DawidKM2026/KM-2026/hello_world/DP_Platform/docs/3d_modeling_files/02_adapter_fl57sth76_gt2/img/fl57sth76_gt2_adapter.png

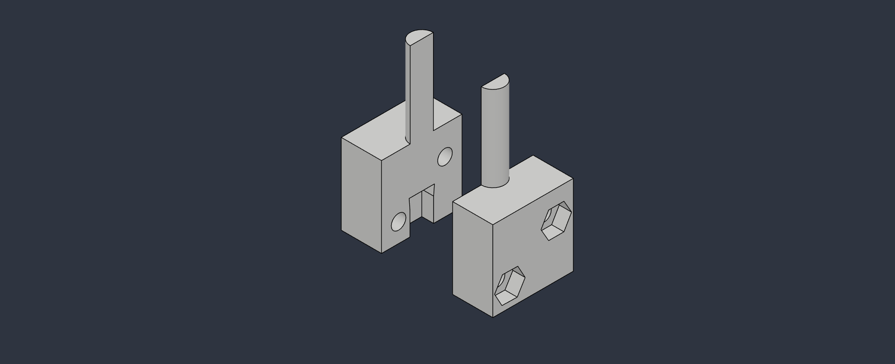
hello_world/DP_Platform/docs/3d_modeling_files/02_adapter_fl57sth76_gt2/img/fl57sth76_gt2_adapter.png
