DawidKM2026/KM-2026/hello_world/DP_Platform/docs/3d_modeling_files/01_spm/cad/rsb-01_axis-main.step

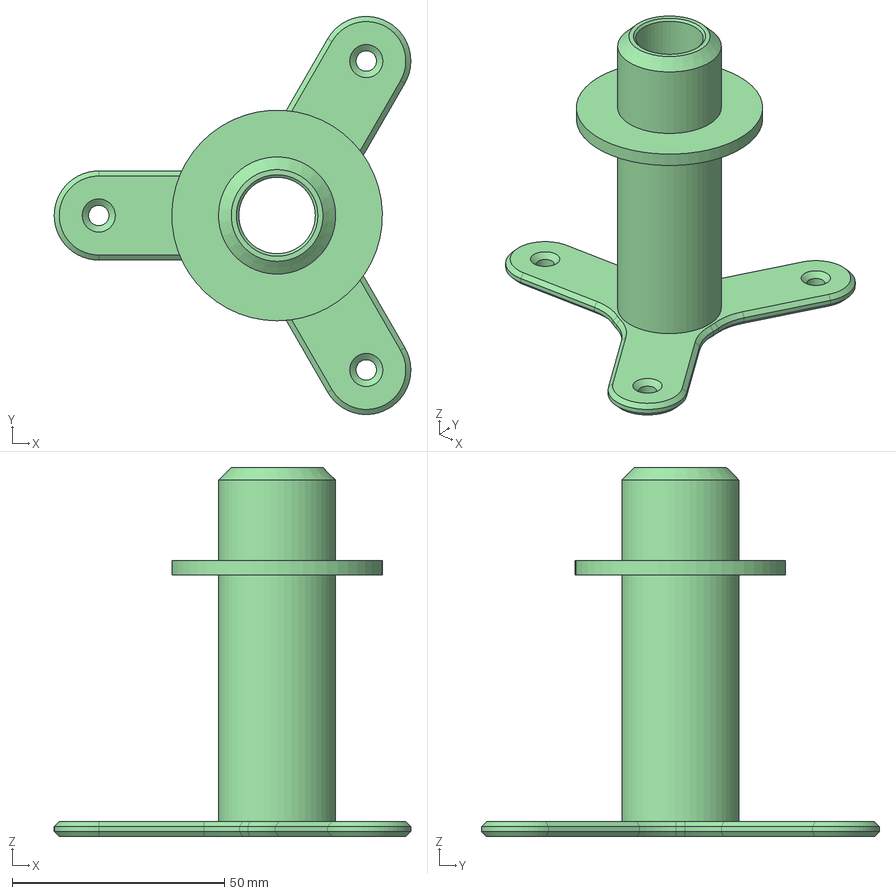
[picture p30: CAD file, 2026-08-04]
hello_world/DP_Platform/docs/3d_modeling_files/01_spm/cad/rsb-01_axis-main.step
84.0 x 93.7 x 87.0 mm
