DawidKM2026/KM-2026/hello_world/DP_Platform/docs/3d_modeling_files/02_adapter_fl57sth76_gt2/cad/fl57sth76_gt2_adapter.step

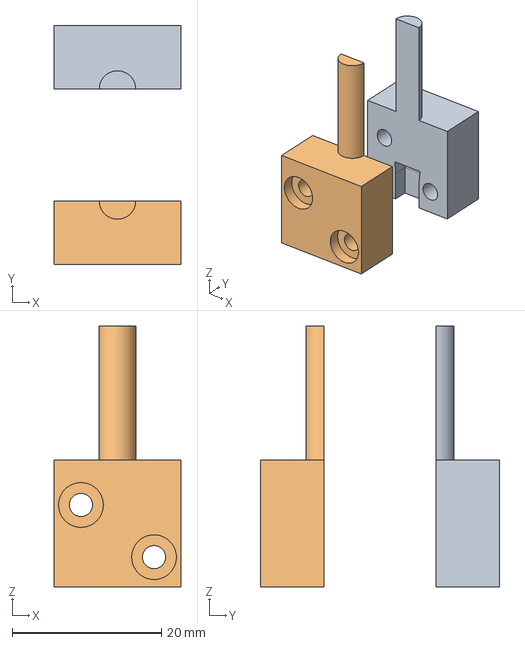
[picture p32: CAD file, 2026-08-04]
hello_world/DP_Platform/docs/3d_modeling_files/02_adapter_fl57sth76_gt2/cad/fl57sth76_gt2_adapter.step
17.0 x 32.0 x 35.0 mm
