DawidKM2026/KM-2026/hello_world/DP_Platform/docs/3d_modeling_files/03_eth_mount/cad/eth_mount.step

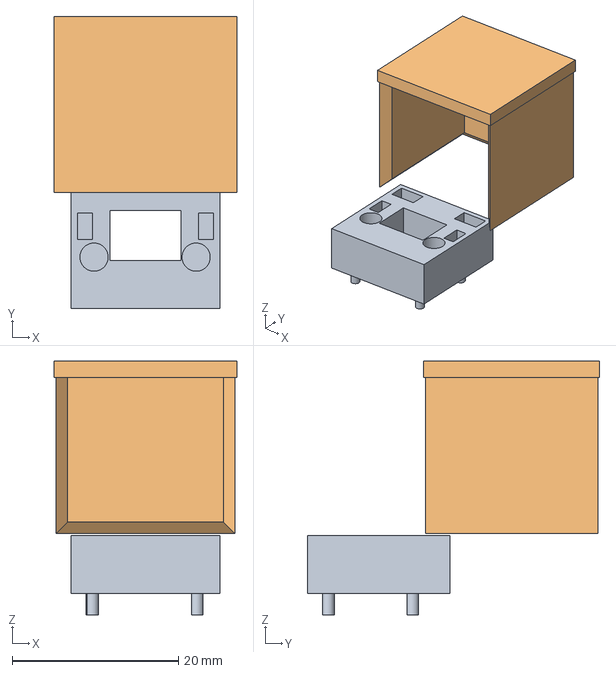
[picture p33: CAD file, 2026-08-04]
hello_world/DP_Platform/docs/3d_modeling_files/03_eth_mount/cad/eth_mount.step
22.0 x 35.2 x 30.6 mm
