DawidKM2026/KM-2026/hello_world/DP_Platform/docs/3d_modeling_files/04_eth_usb_mount/cad/eth_usb_mount.step

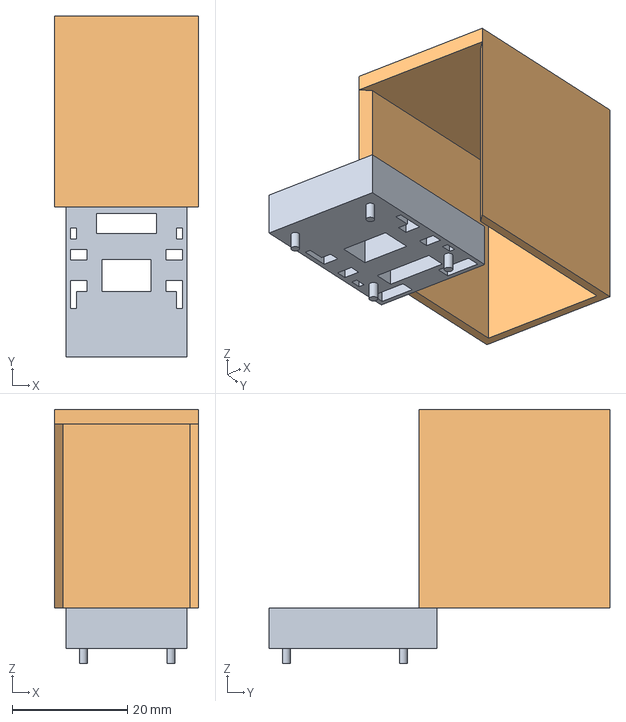
[picture p34: CAD file, 2026-08-04]
hello_world/DP_Platform/docs/3d_modeling_files/04_eth_usb_mount/cad/eth_usb_mount.step
25.0 x 59.2 x 44.1 mm
