DawidKM2026/KM-2026/hello_world/DP_Platform/docs/3d_modeling_files/05_mounting_base_xl4016/cad/mounting_base_xl4016.step

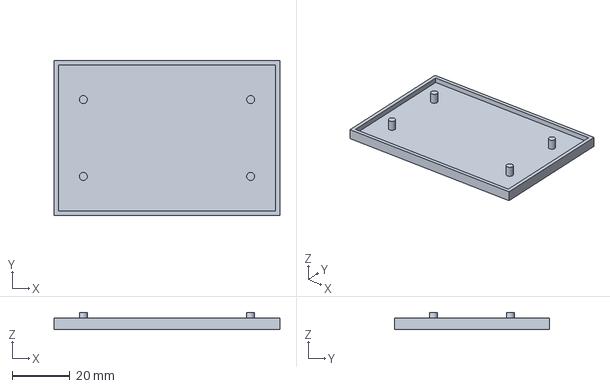
[picture p35: CAD file, 2026-08-04]
hello_world/DP_Platform/docs/3d_modeling_files/05_mounting_base_xl4016/cad/mounting_base_xl4016.step
78.5 x 53.7 x 6.00 mm
