DawidKM2026/KM-2026/hello_world/DP_Platform/docs/3d_modeling_files/06_expansion_platform_gantry/cad/expansion_platform_gantry.step

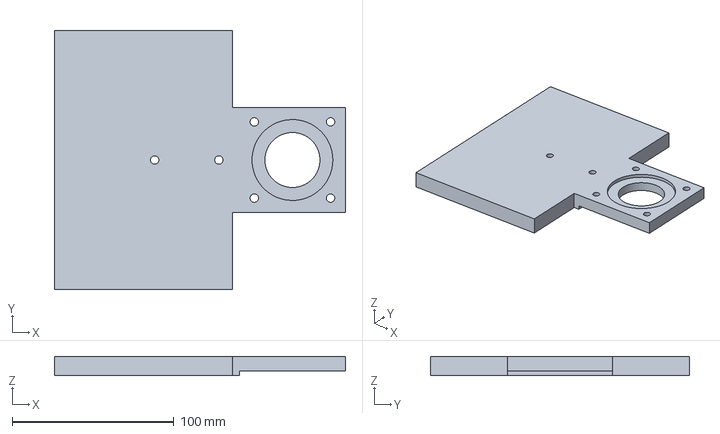
[picture p36: CAD file, 2026-08-04]
hello_world/DP_Platform/docs/3d_modeling_files/06_expansion_platform_gantry/cad/expansion_platform_gantry.step
179.9 x 160.0 x 12.0 mm
