DawidKM2026/KM-2026/hello_world/DP_Platform/docs/3d_modeling_files/07_riser_feet_2020/cad/riser_leg.step

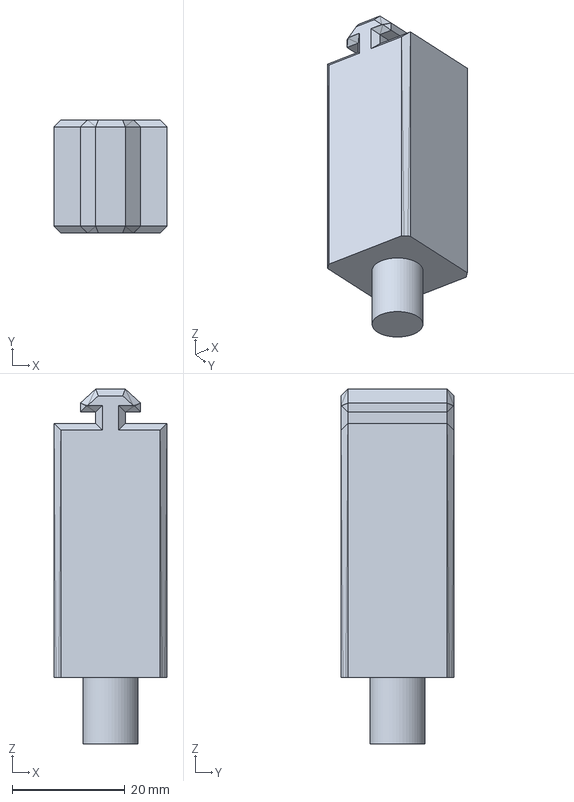
[picture p37: CAD file, 2026-08-04]
hello_world/DP_Platform/docs/3d_modeling_files/07_riser_feet_2020/cad/riser_leg.step
20.0 x 20.0 x 62.9 mm
