DawidKM2026/KM-2026/hello_world/DP_Platform/docs/3d_modeling_files/08_mount_gear_jk42hs34/cad/gear.step

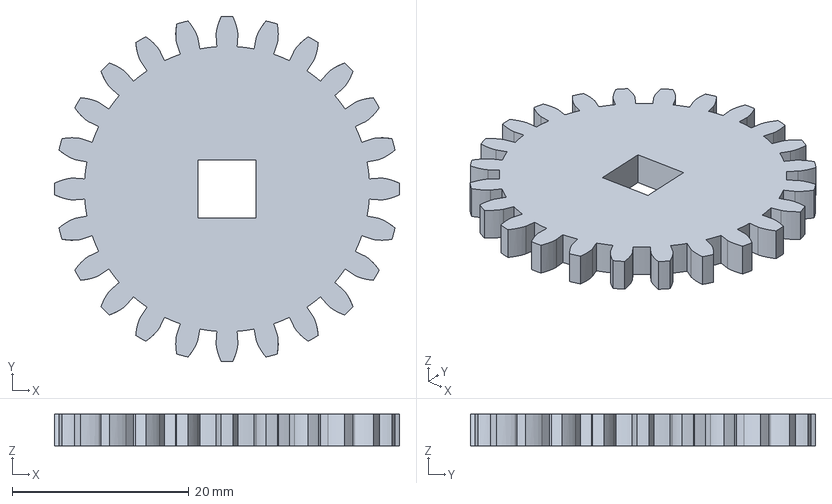
[picture p38: CAD file, 2026-08-04]
hello_world/DP_Platform/docs/3d_modeling_files/08_mount_gear_jk42hs34/cad/gear.step
39.0 x 39.0 x 3.60 mm
