DawidKM2026/KM-2026/hello_world/DP_Platform/docs/3d_modeling_files/09_fl57sth76_mount_vslot_frame/cad/fl57sth76_vslot_mount.step

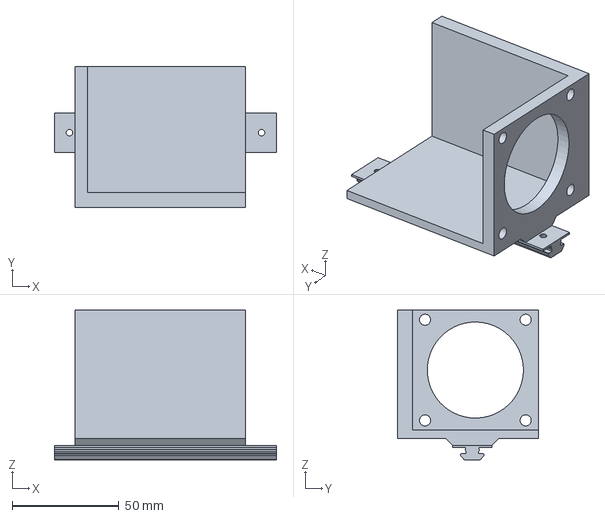
[picture p39: CAD file, 2026-08-04]
hello_world/DP_Platform/docs/3d_modeling_files/09_fl57sth76_mount_vslot_frame/cad/fl57sth76_vslot_mount.step
104.0 x 66.0 x 70.2 mm
