DawidKM2026/KM-2026/hello_world/DP_Platform/docs/3d_modeling_files/10_sar_brage_hull/cad/sar_brage.step

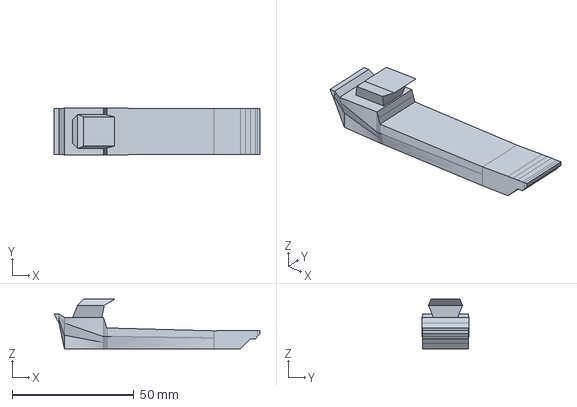
[picture p40: CAD file, 2026-08-04]
hello_world/DP_Platform/docs/3d_modeling_files/10_sar_brage_hull/cad/sar_brage.step
84.7 x 19.2 x 20.4 mm
