DawidKM2026/KM-2026/hello_world/DP_Platform/docs/3d_modeling_files/11_vslot_corner_bracket/cad/45Bracket_.step

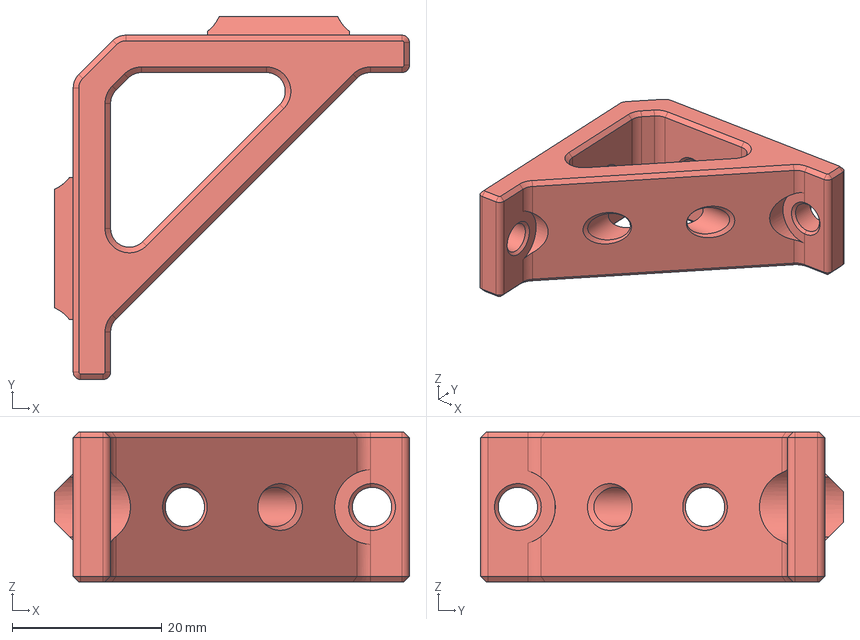
[picture p41: CAD file, 2026-08-06]
hello_world/DP_Platform/docs/3d_modeling_files/11_vslot_corner_bracket/cad/45Bracket_.step
47.4 x 48.5 x 20.0 mm
