DawidKM2026/KM-2026/hello_world/DP_Platform/docs/3d_modeling_files/01_spm/cad/rsb-01_base-axis-01_gear_version.step

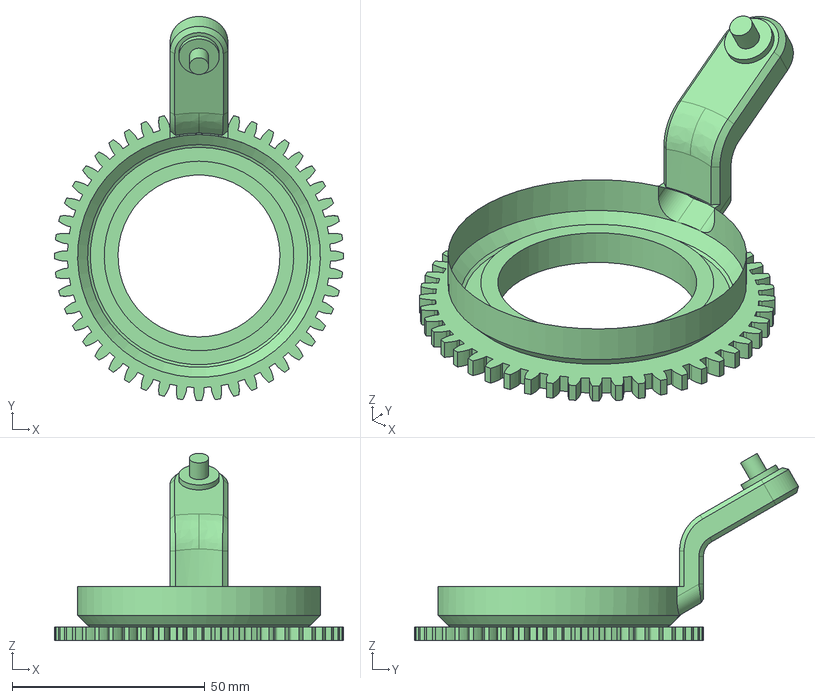
[picture p42: CAD file, 2026-08-04]
hello_world/DP_Platform/docs/3d_modeling_files/01_spm/cad/rsb-01_base-axis-01_gear_version.step
75.0 x 99.6 x 48.6 mm
