DawidKM2026/KM-2026/hello_world/DP_Platform/docs/3d_modeling_files/07_riser_feet_2020/cad/expanding_foot.step

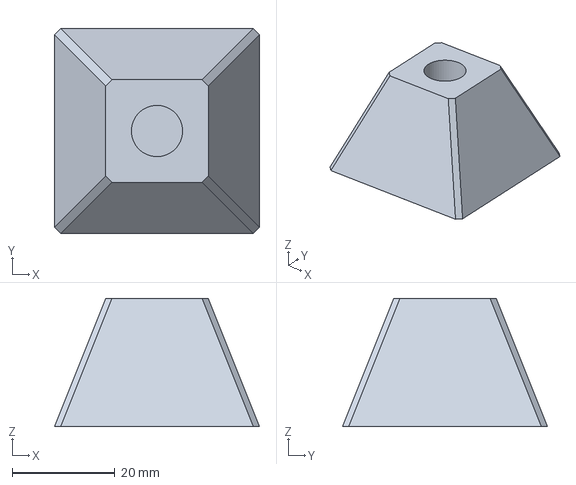
[picture p43: CAD file, 2026-08-04]
hello_world/DP_Platform/docs/3d_modeling_files/07_riser_feet_2020/cad/expanding_foot.step
40.0 x 40.0 x 25.0 mm
