DawidKM2026/KM-2026/hello_world/DP_Platform/docs/3d_modeling_files/01_spm/cad/rsb-01_base-axis-03_gear_version.step

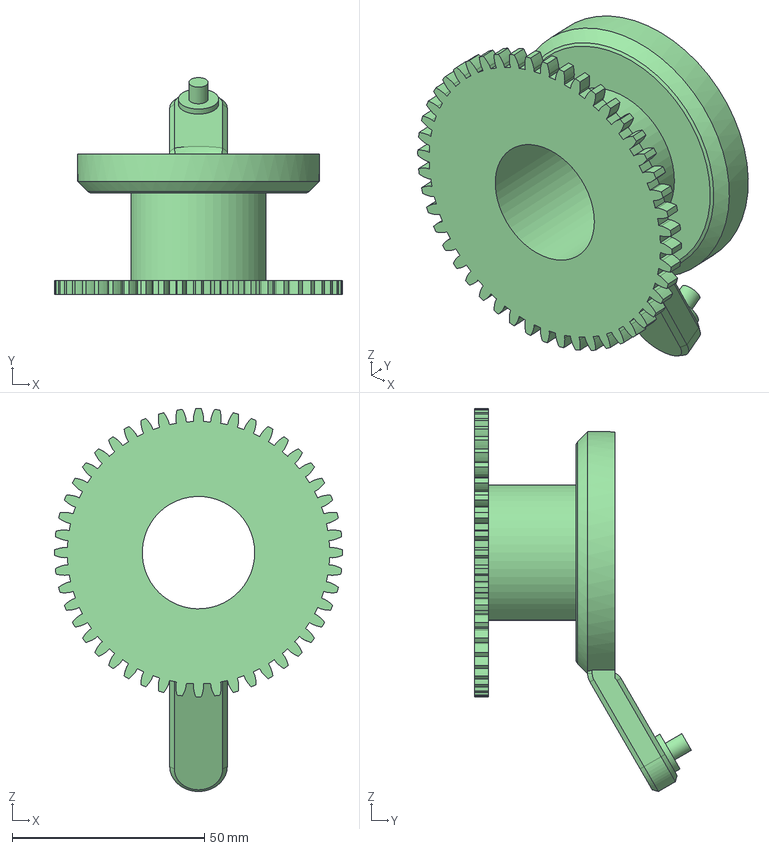
[picture p44: CAD file, 2026-08-04]
hello_world/DP_Platform/docs/3d_modeling_files/01_spm/cad/rsb-01_base-axis-03_gear_version.step
75.0 x 56.4 x 99.6 mm
