DawidKM2026/KM-2026/hello_world/DP_Platform/docs/3d_modeling_files/01_spm/cad/rsb-01_arm-axis-all.step

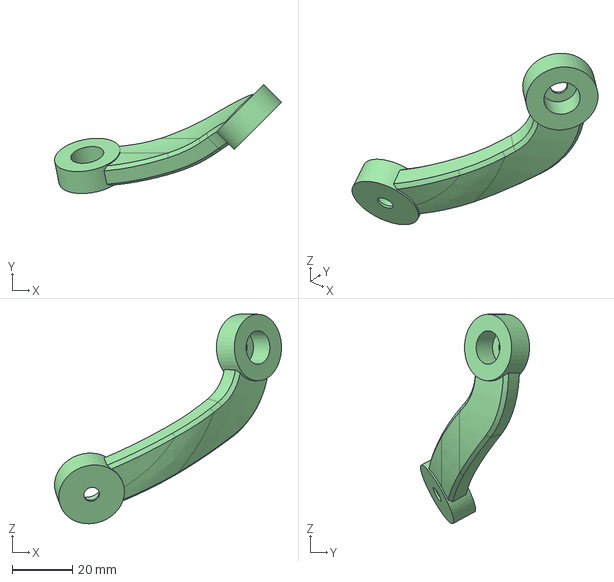
[picture p45: CAD file, 2026-08-04]
hello_world/DP_Platform/docs/3d_modeling_files/01_spm/cad/rsb-01_arm-axis-all.step
75.2 x 36.1 x 69.4 mm
