DawidKM2026/KM-2026/hello_world/DP_Platform/docs/3d_modeling_files/08_mount_gear_jk42hs34/cad/bolted_clamp.step

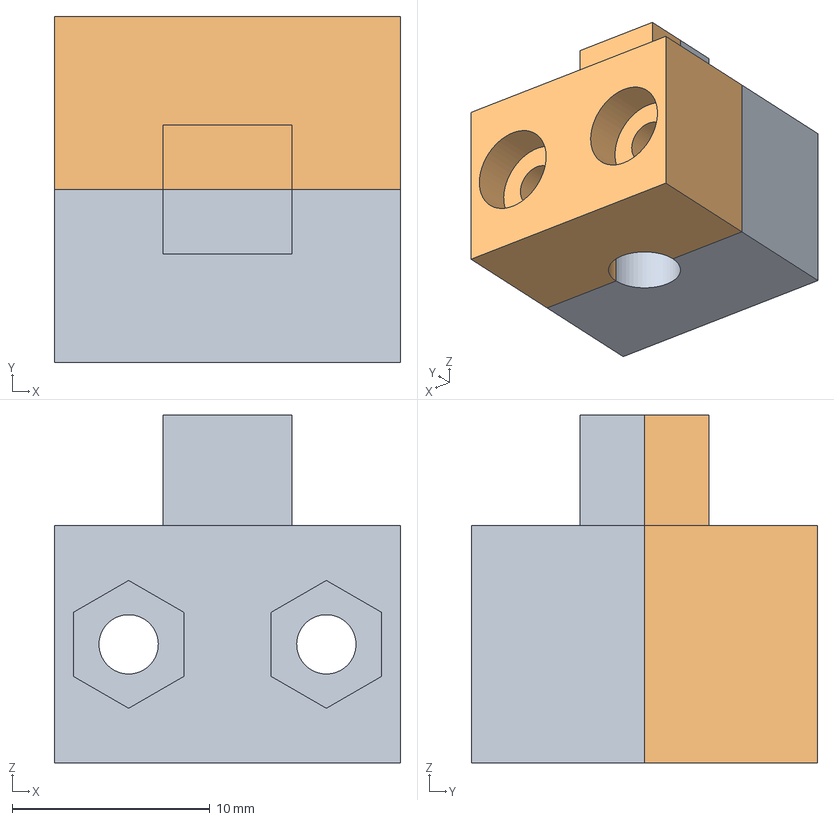
[picture p47: CAD file, 2026-08-04]
hello_world/DP_Platform/docs/3d_modeling_files/08_mount_gear_jk42hs34/cad/bolted_clamp.step
17.5 x 17.5 x 17.6 mm
