DawidKM2026/KM-2026/(list of files, cad)

Other CAD files:
hello_world/DP_Platform/docs/3d_modeling_files/01_spm/cad/rsb-01_arm-axis-all.3mf
hello_world/DP_Platform/docs/3d_modeling_files/01_spm/cad/rsb-01_arm-axis-all.f3d
hello_world/DP_Platform/docs/3d_modeling_files/01_spm/cad/rsb-01_axis-main.3mf
hello_world/DP_Platform/docs/3d_modeling_files/01_spm/cad/rsb-01_axis-main.f3d
hello_world/DP_Platform/docs/3d_modeling_files/01_spm/cad/rsb-01_base-axis-01_gear_version.3mf
hello_world/DP_Platform/docs/3d_modeling_files/01_spm/cad/rsb-01_base-axis-01_gear_version.f3d
hello_world/DP_Platform/docs/3d_modeling_files/01_spm/cad/rsb-01_base-axis-02_gear_version.3mf
hello_world/DP_Platform/docs/3d_modeling_files/01_spm/cad/rsb-01_base-axis-02_gear_version.f3d
hello_world/DP_Platform/docs/3d_modeling_files/01_spm/cad/rsb-01_base-axis-03_gear_version.3mf
hello_world/DP_Platform/docs/3d_modeling_files/01_spm/cad/rsb-01_base-axis-03_gear_version.f3d
hello_world/DP_Platform/docs/3d_modeling_files/01_spm/cad/rsb-01_top.3mf
hello_world/DP_Platform/docs/3d_modeling_files/01_spm/cad/rsb-01_top.f3d
hello_world/DP_Platform/docs/3d_modeling_files/02_adapter_fl57sth76_gt2/cad/fl57sth76_gt2_adapter.3mf
hello_world/DP_Platform/docs/3d_modeling_files/02_adapter_fl57sth76_gt2/cad/fl57sth76_gt2_adapter.f3d
hello_world/DP_Platform/docs/3d_modeling_files/03_eth_mount/cad/eth_mount.3mf
hello_world/DP_Platform/docs/3d_modeling_files/03_eth_mount/cad/eth_mount.f3d
hello_world/DP_Platform/docs/3d_modeling_files/04_eth_usb_mount/cad/eth_usb_mount.3mf
hello_world/DP_Platform/docs/3d_modeling_files/04_eth_usb_mount/cad/eth_usb_mount.f3d
hello_world/DP_Platform/docs/3d_modeling_files/05_mounting_base_xl4016/cad/mounting_base_xl4016.3mf
hello_world/DP_Platform/docs/3d_modeling_files/05_mounting_base_xl4016/cad/mounting_base_xl4016.f3d
hello_world/DP_Platform/docs/3d_modeling_files/06_expansion_platform_gantry/cad/expansion_platform_gantry.3mf
hello_world/DP_Platform/docs/3d_modeling_files/06_expansion_platform_gantry/cad/expansion_platform_gantry.f3d
hello_world/DP_Platform/docs/3d_modeling_files/07_riser_feet_2020/cad/expanding_foot.3mf
hello_world/DP_Platform/docs/3d_modeling_files/07_riser_feet_2020/cad/expanding_foot.f3d
hello_world/DP_Platform/docs/3d_modeling_files/07_riser_feet_2020/cad/riser_leg.3mf
hello_world/DP_Platform/docs/3d_modeling_files/07_riser_feet_2020/cad/riser_leg.f3d
hello_world/DP_Platform/docs/3d_modeling_files/08_mount_gear_jk42hs34/cad/bolted_clamp.3mf
hello_world/DP_Platform/docs/3d_modeling_files/08_mount_gear_jk42hs34/cad/bolted_clamp.f3d
hello_world/DP_Platform/docs/3d_modeling_files/08_mount_gear_jk42hs34/cad/gear.3mf
hello_world/DP_Platform/docs/3d_modeling_files/08_mount_gear_jk42hs34/cad/gear.f3d
hello_world/DP_Platform/docs/3d_modeling_files/09_fl57sth76_mount_vslot_frame/cad/fl57sth76_vslot_mount.3mf
hello_world/DP_Platform/docs/3d_modeling_files/09_fl57sth76_mount_vslot_frame/cad/fl57sth76_vslot_mount.f3d
hello_world/DP_Platform/docs/3d_modeling_files/10_sar_brage_hull/cad/sar_brage.3mf
hello_world/DP_Platform/docs/3d_modeling_files/10_sar_brage_hull/cad/sar_brage.f3d
