DawidKM2026/KM-2026/hello_world/DP_Platform/docs/images/KM2026_1.pdf

# ~{RESET} 13 ~{SLEEP} 14 ~{ENABLE} 9 STEP 15 DIR 16 MS1 10 MS2 11 MS3 12 VDD

# 2B 6 STEP_X_1 A4988 +12V

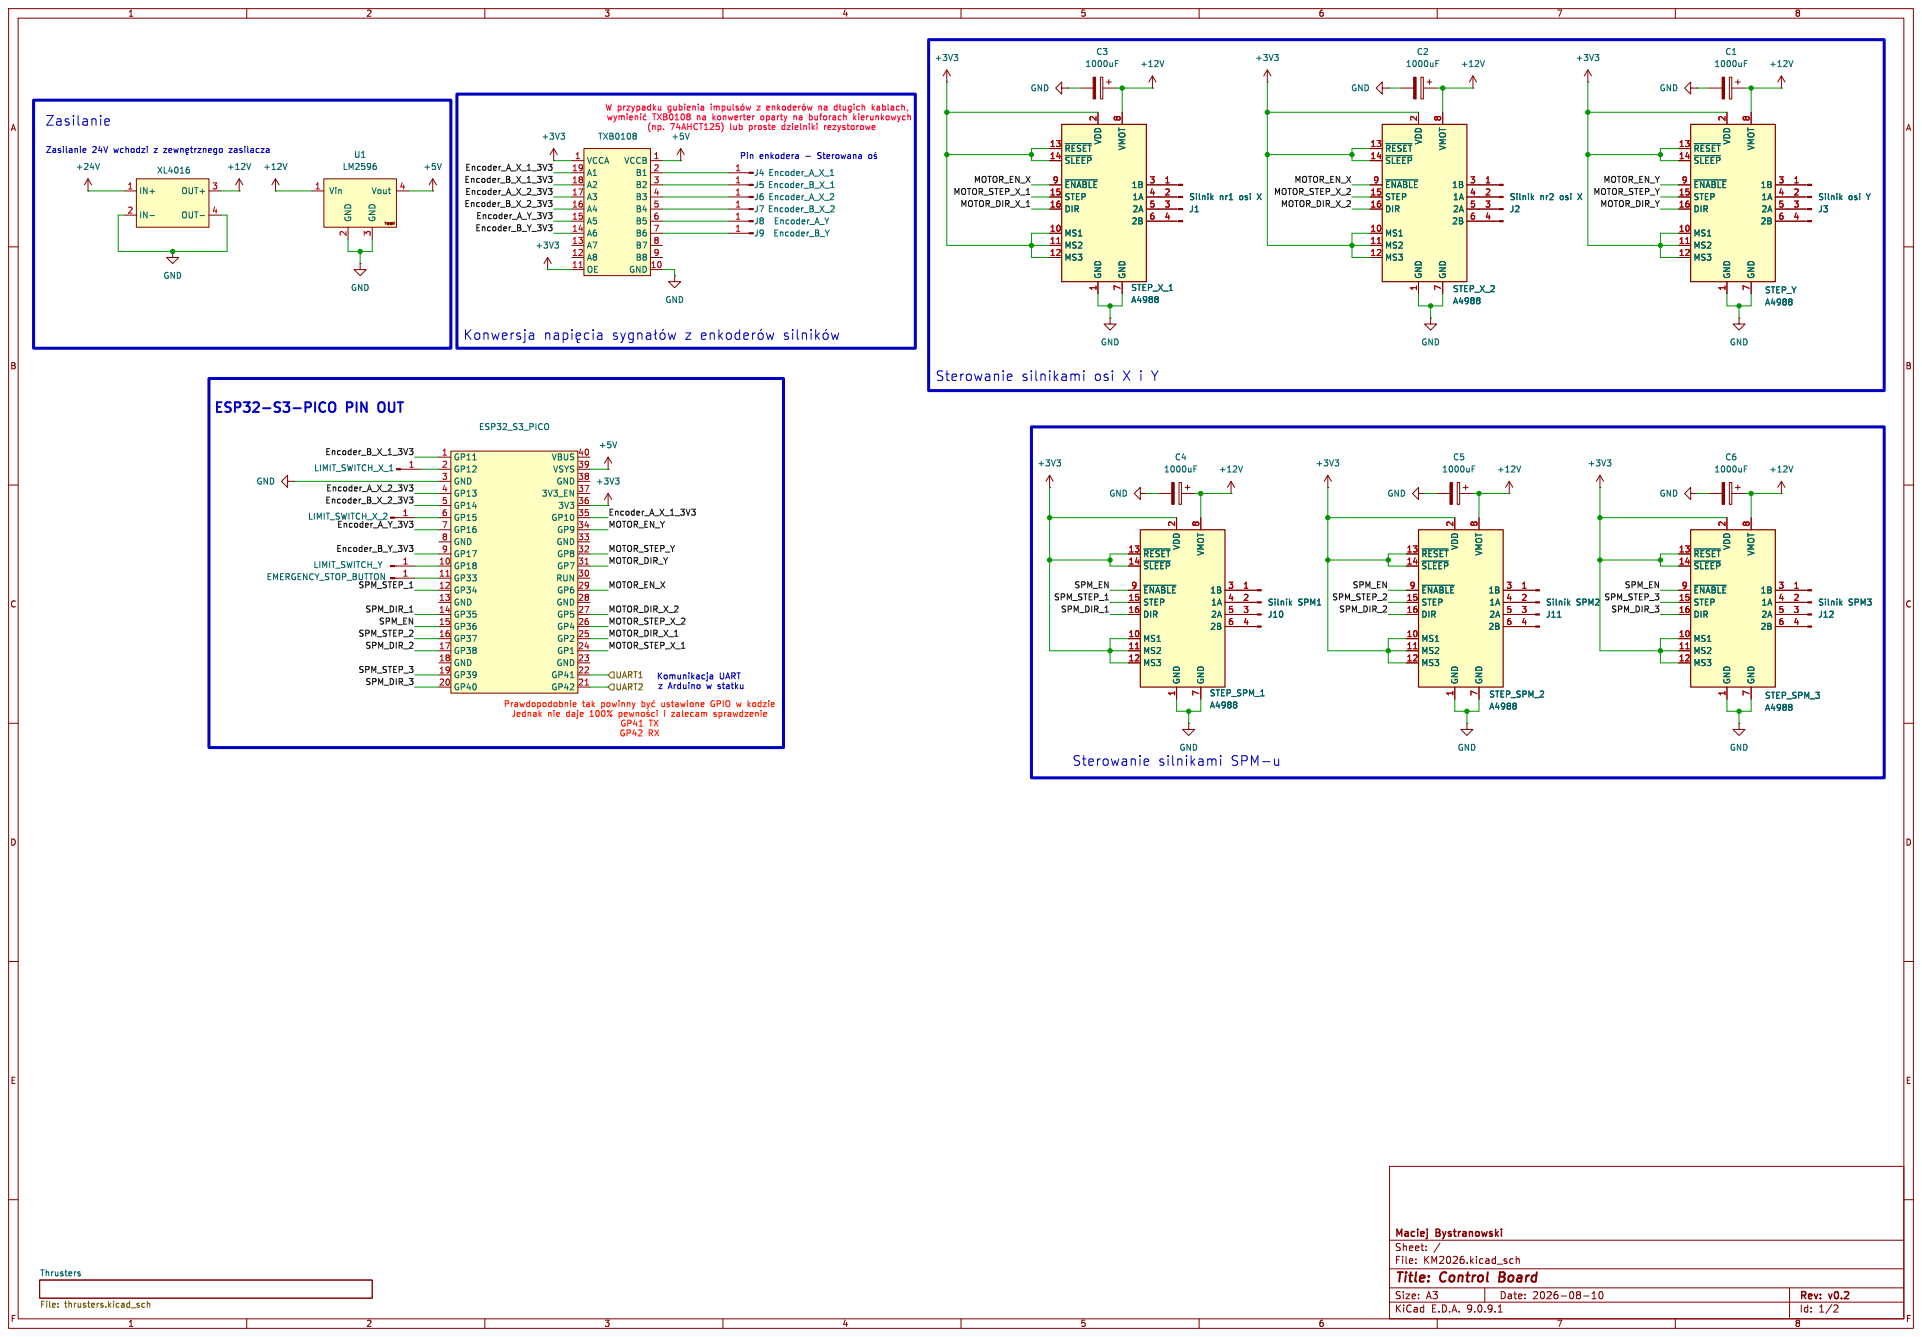
[picture p52: page 1]

GND
~{RESET} 13 ~{SLEEP} 14 ~{ENABLE} 9 STEP

3 Vout 4 U1 +12V LM2596 ~{RESET} 13 ~{SLEEP} 14 ~{ENABLE} 9 STEP 15 DIR 16 MS1 10 MS2 11 MS3 12 VDD

A4988 ~{RESET} 13 ~{SLEEP} 14 ~{ENABLE} 9 STEP

Jednak nie daje 100% þÿpewno[ci i zalecam sprawdzenie GP41 TX GP42 RX Konwersja þÿnapicia þÿsygnaBów z þÿenkoderów þÿsilników

1000uF GND

4 STEP_SPM_3 A4988 ~{RESET} 13 ~{SLEEP} 14 ~{ENABLE} 9 STEP

Id: 1/2 Title: Control Board
