DawidKM2026/KM-2026/hello_world/DP_Platform/docs/images/KM2026_2.pdf

# 5V 4 A7 5 A6 6 A5 7 A4 8 A3 9 A2 10 A1 11 A0 12 REF 13

# 4 motorID2 ULN2003R1

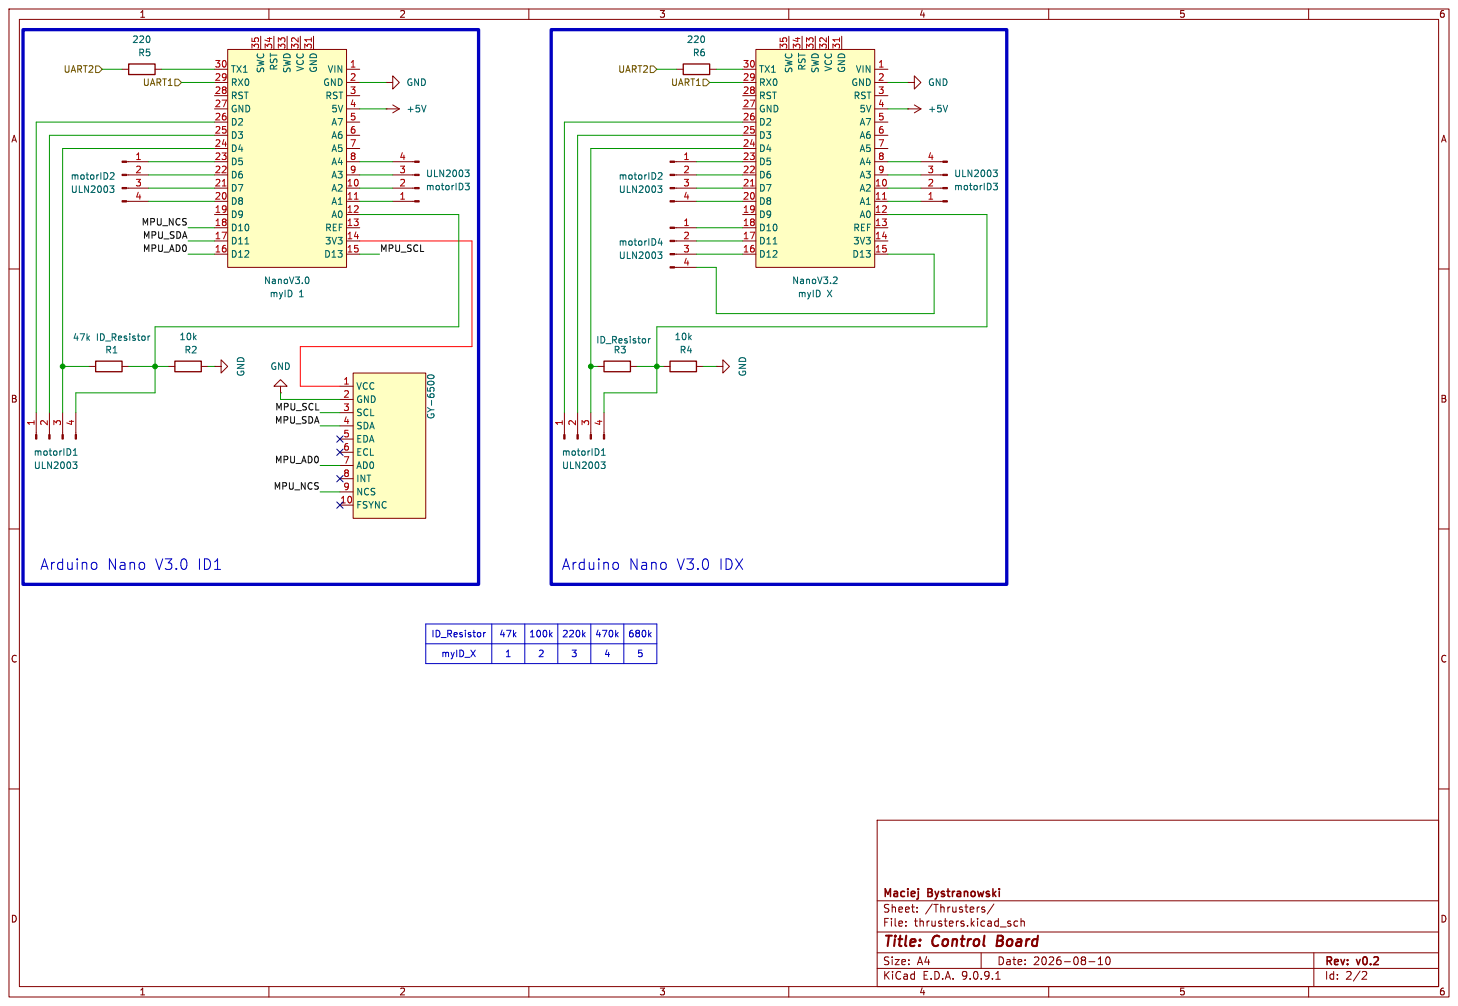
[picture p53: page 1]

Id: 2/2 Title: Control Board
