DawidKM2026/KM-2026/hello_world/DP_Platform/docs/images/KM2026.pdf

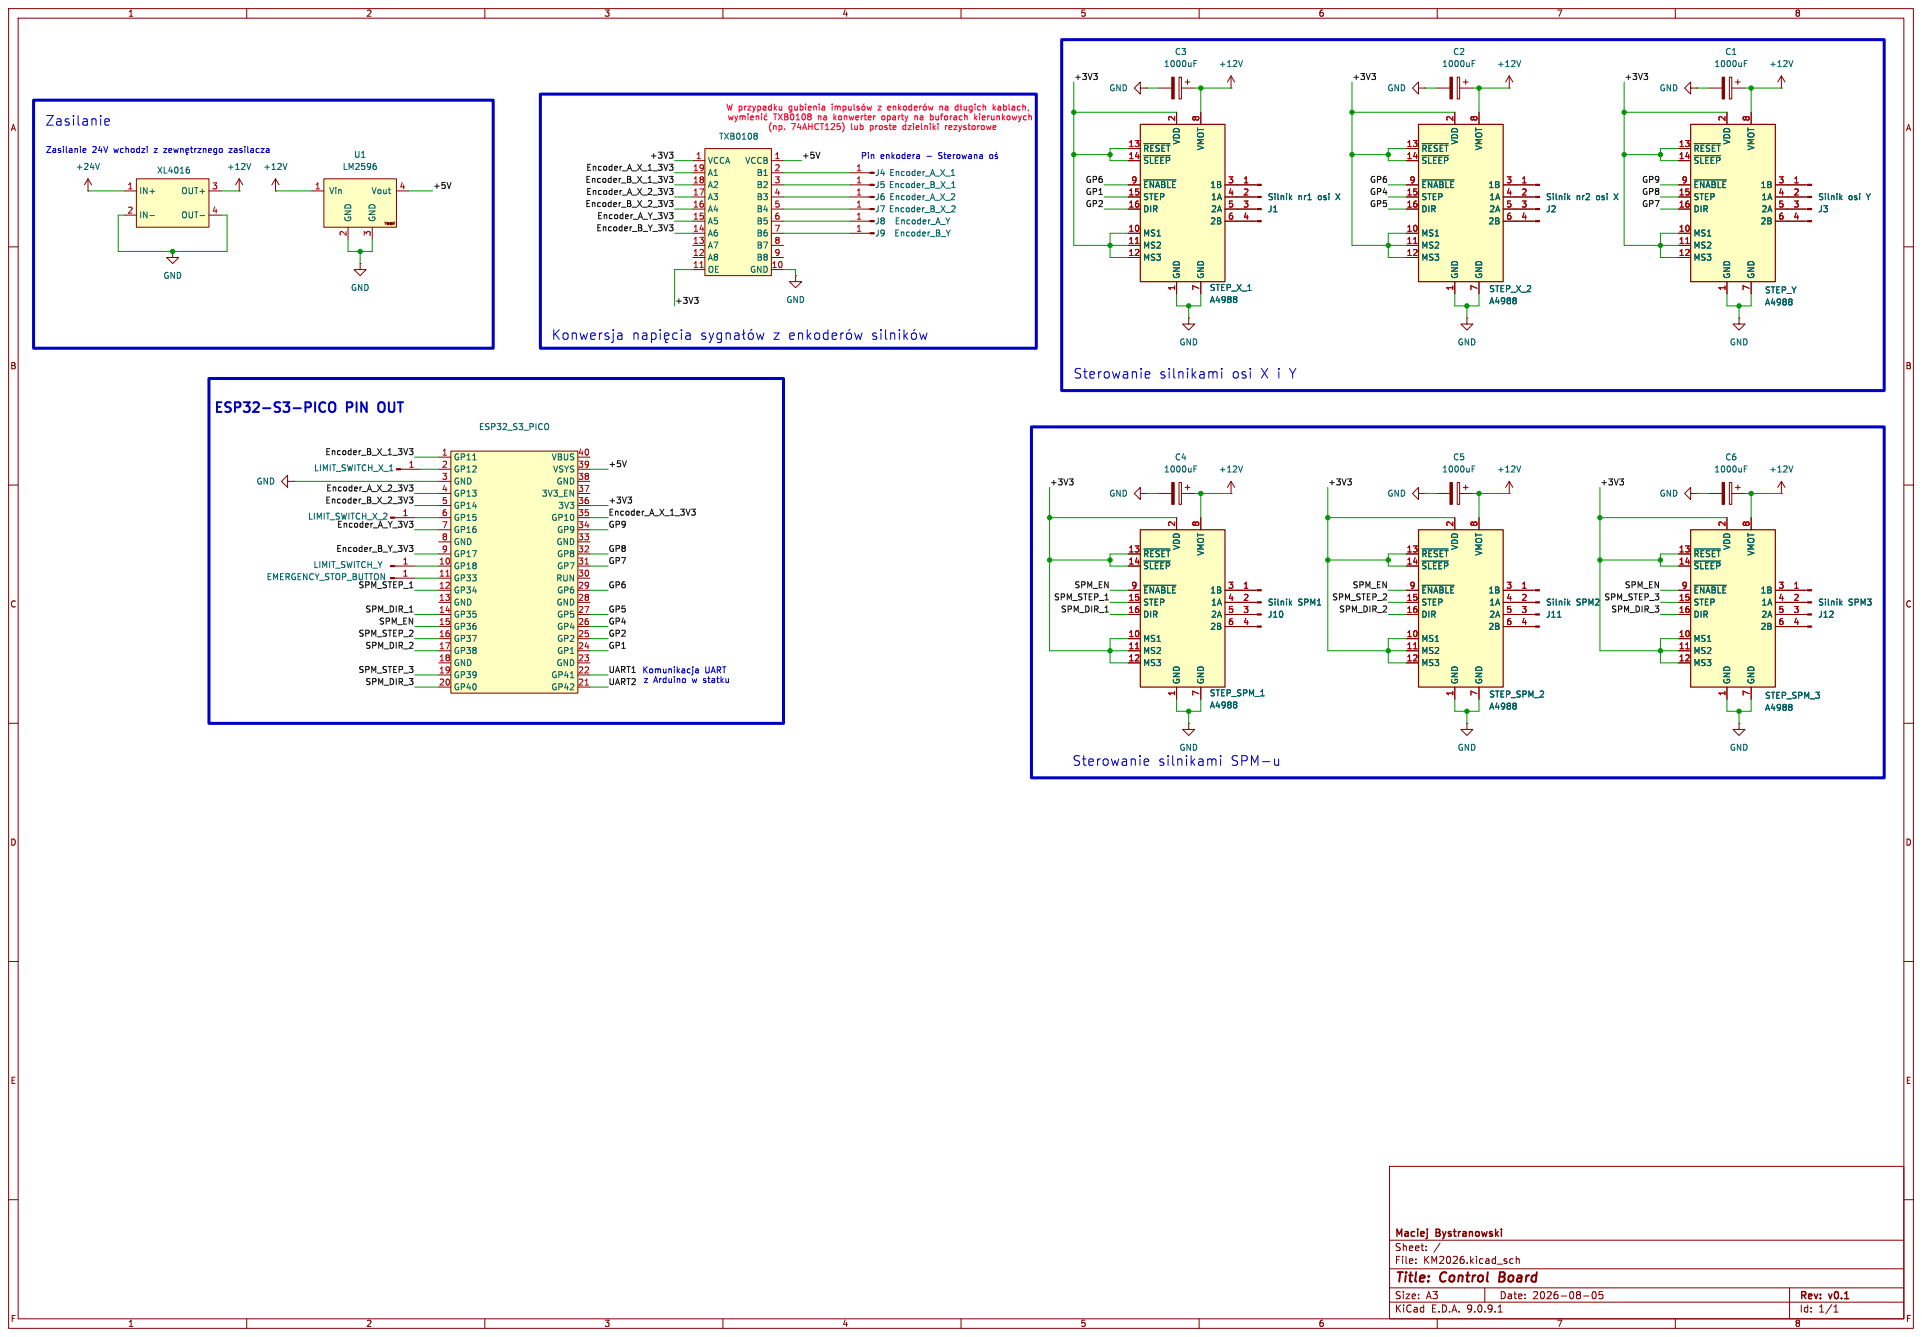
[picture p54: page 1]

2 GND
~{RESET} 13 ~{SLEEP} 14 ~{ENABLE} 9 STEP

8 GND
A4988 ~{RESET} 13 ~{SLEEP} 14 ~{ENABLE} 9 STEP

Konwersja þÿnapicia þÿsygnaBów z þÿenkoderów þÿsilników

J12 Silnik SPM3 ~{RESET} 13 ~{SLEEP} 14 ~{ENABLE} 9 STEP

Id: 1/1 Title: Control Board
