DawidKM2026/KM-2026/hello_world/main/SPM/spm_motors.h

#ifndef SPM_MOTORS_H
#define SPM_MOTORS_H

#include <stdint.h>
#include <stdbool.h>

void spm_motors_init(void);

bool spm_motors_move_steps(
    int32_t motor1_steps,
    int32_t motor2_steps,
    int32_t motor3_steps,
    float speed_rps);

void spm_motors_stop(void);

// spm_motors.h

bool spm_motors_move_rpy(
    float roll_deg,
    float pitch_deg,
    float yaw_deg,
    float speed_rps);

void spm_motors_get_actual_angles(float *roll,
    float *pitch,
    float *yaw);

void spm_motors_get_target_angles(float *roll,
   float *pitch,
   float *yaw);

#endif
