DawidKM2026/KM-2026/hello_world/main/GPIO/gpio_config.c

#include "gpio_config.h"

void init_gpio(void)
{
    gpio_set_direction(STEP_X_1_PIN, GPIO_MODE_OUTPUT);
    gpio_set_direction(DIR_X_1_PIN, GPIO_MODE_OUTPUT);
    gpio_set_direction(EN_X_PIN, GPIO_MODE_OUTPUT);
    
    gpio_set_direction(STEP_X_2_PIN, GPIO_MODE_OUTPUT);
    gpio_set_direction(DIR_X_2_PIN, GPIO_MODE_OUTPUT);

    gpio_set_direction(STEP_Y_PIN, GPIO_MODE_OUTPUT);
    gpio_set_direction(DIR_Y_PIN, GPIO_MODE_OUTPUT);
    gpio_set_direction(EN_Y_PIN, GPIO_MODE_OUTPUT);

    //Przycisk na ESP 32 S3 PICO
    gpio_set_direction(BUTTON_PIN, GPIO_MODE_INPUT);
    gpio_set_pull_mode(BUTTON_PIN, GPIO_PULLUP_ONLY);

    //Grzybek (Emergency Stop)
    gpio_set_direction(EMERGENCY_STOP_PIN, GPIO_MODE_INPUT);
    gpio_set_pull_mode(EMERGENCY_STOP_PIN, GPIO_PULLUP_ONLY);

    //Krańcówki
    gpio_set_direction(LIMIT_SWITCH_X_1_PIN, GPIO_MODE_INPUT);
    gpio_set_pull_mode(LIMIT_SWITCH_X_1_PIN, GPIO_PULLUP_ONLY);
    
    gpio_set_direction(LIMIT_SWITCH_X_2_PIN, GPIO_MODE_INPUT);
    gpio_set_pull_mode(LIMIT_SWITCH_X_2_PIN, GPIO_PULLUP_ONLY);
    
    gpio_set_direction(LIMIT_SWITCH_Y_PIN, GPIO_MODE_INPUT);
    gpio_set_pull_mode(LIMIT_SWITCH_Y_PIN, GPIO_PULLUP_ONLY);

    gpio_set_direction(SPM_STEP_1_PIN, GPIO_MODE_OUTPUT);
    gpio_set_direction(SPM_DIR_1_PIN, GPIO_MODE_OUTPUT);
    gpio_set_direction(SPM_EN_PIN, GPIO_MODE_OUTPUT);
    
    gpio_set_direction(SPM_STEP_2_PIN, GPIO_MODE_OUTPUT);
    gpio_set_direction(SPM_DIR_2_PIN, GPIO_MODE_OUTPUT);

    gpio_set_direction(SPM_STEP_3_PIN, GPIO_MODE_OUTPUT);
    gpio_set_direction(SPM_DIR_3_PIN, GPIO_MODE_OUTPUT);
}
