DawidKM2026/KM-2026/(commit log)

2026-07-06 Stworzenie partycji +Access Point + www
    [partitions.csv]
2026-07-13 Zmieniono silnik IntelliSense na wyłączony oraz dodano funkcje do obsługi enkodera w pliku stepper_motor.h
2026-07-13 Dodano obsługę enkodera w pliku stepper_motor.c
2026-07-14 Zmieniono wartość ENCODER_CPR na 200 w celu poprawy dokładności pomiarów enkodera
2026-07-14 Refactor motor_move_by function to improve clarity and remove commented-out code
2026-07-21 Poprawki bug'ów + dodanie zabezpieczeń
    [bresenham.h, esp_now_comm.c, stepper_motor.c, stepper_motor.h]
2026-07-28 Add UART communication and thruster control functionality
2026-07-30 Implement inverse kinematics calculations and add movement functions for roll, pitch, and yaw
2026-07-31 Extend ESP-NOW protocol with SPM control commands, roll/pitch/yaw support and motor telemetry reporting. Add target and actual motor angle feedback for remote monitoring and control.
2026-08-03 Refactor project structure and implement state management for system boot and operation. Add emergency stop functionality and enhance ESP-NOW communication. Introduce system state handling with dedic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
2026-08-04 3d modeling documentation with all cad files
    [bolted_clamp.3mf, bolted_clamp.f3d, bolted_clamp.step, eth_mount.3mf, eth_mount.f3d, eth_mount.step, eth_usb_mount.3mf, eth_usb_mount.f3d]
2026-08-05 Add telemetry data handling for UART communication
2026-08-05 Implement telemetry data handling in UART communication
2026-08-05 Refactor telemetry data structure and update UART communication integration
2026-08-06 Add hardware schematic and 3d printed model to documentation
    [45Bracket_.step]
2026-08-10 Add UART communication initialization and update documentation structure
2026-08-10 Add updated hardware schematic with KiCad zip project
2026-08-11 Enhance documentation for GPIO configuration and software modules, including inverse kinematics and motor control details.
